jackcannon/hotline/docs/README.md

# Hotline documentation

| Page | Contents |
| --- | --- |
| [Build guide](build-guide.md) | Make a Hotline, step by step: parts, printing, the handset, the board, the wiring, flashing and testing |
| [Wiring](wiring.md) | The wiring diagram, the pin map, the ProtoMate layout, and each connection |
| [Firmware](firmware.md) | Build and flash the firmware, settings, how it works, known issues and troubleshooting |
| [3D-printed parts](../models/README.md) | The seven printed parts, where each one goes, and the print settings |
| [Wiring diagram (interactive)](hotline_complete_wiring_v12.html) | The same diagram as on the wiring page, as a web page with a dark mode |

To use a finished Hotline, see the [README](../README.md).
