jackcannon/hotline/assets/hotline-dial-card-2400.png

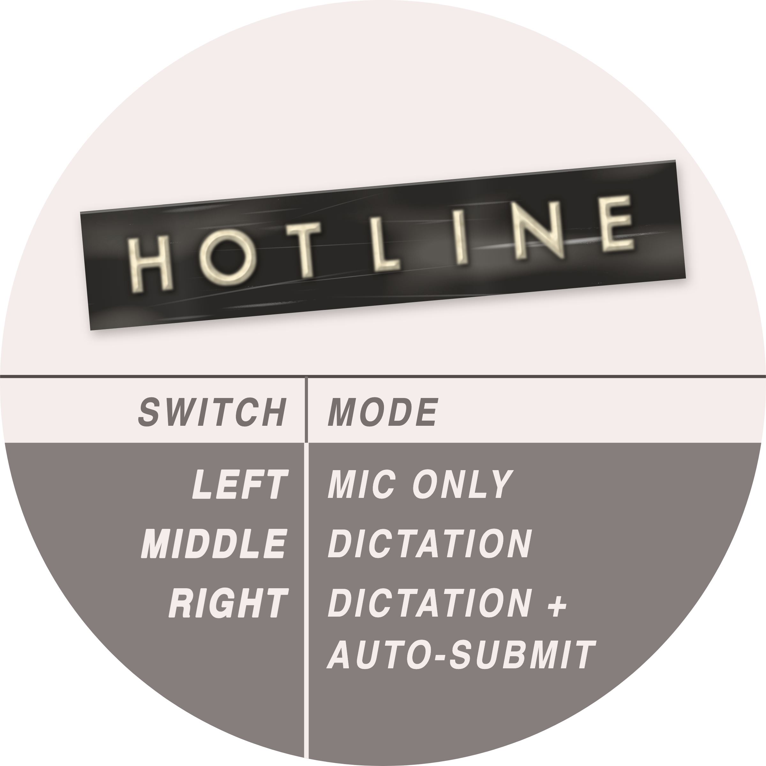
assets/hotline-dial-card-2400.png
