jackcannon/hotline/photos/hotline-desk.jpg

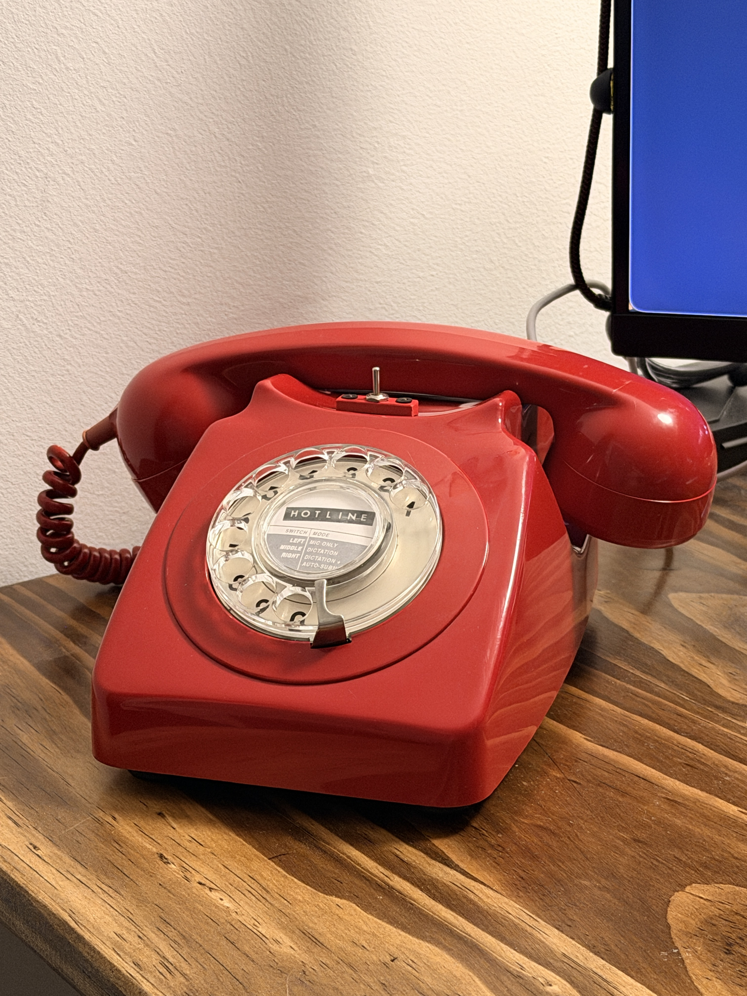
photos/hotline-desk.jpg
