jackcannon/hotline/models/Top Panel Main.stl

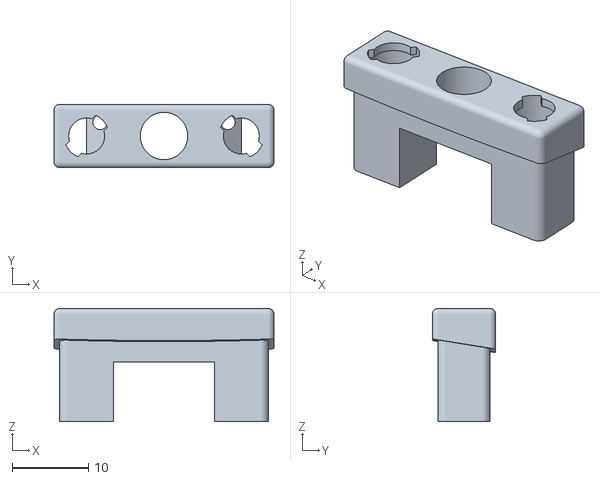
[picture p5: CAD file, 2026-10-31]
models/Top Panel Main.stl
28.8 x 8.30 x 14.8
