jackcannon/hotline/models/Back Port Cover.stl

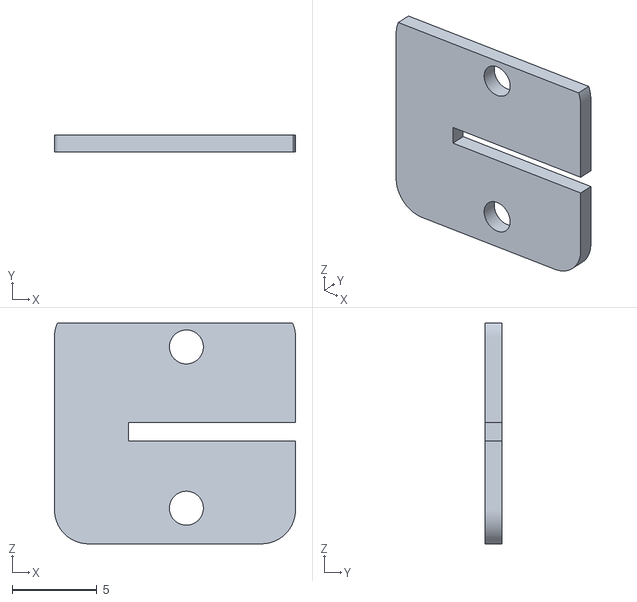
[picture p6: CAD file, 2026-10-31]
models/Back Port Cover.stl
14.2 x 1.00 x 13.0
