jackcannon/hotline/models/Microphone Cover.stl

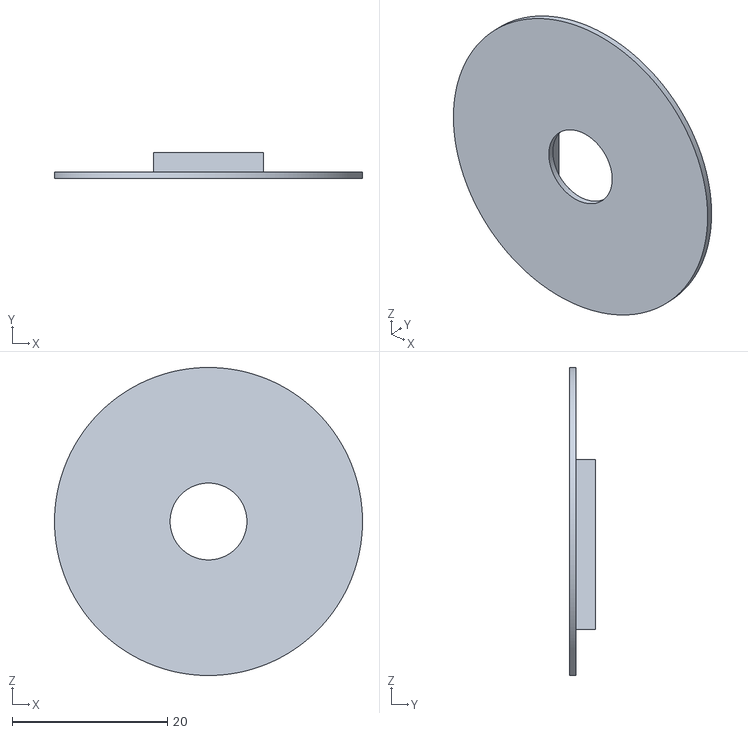
[picture p7: CAD file, 2026-10-31]
models/Microphone Cover.stl
39.7 x 3.30 x 39.7
