jackcannon/hotline/models/PRINT SETTINGS - 0.2mm.3mf

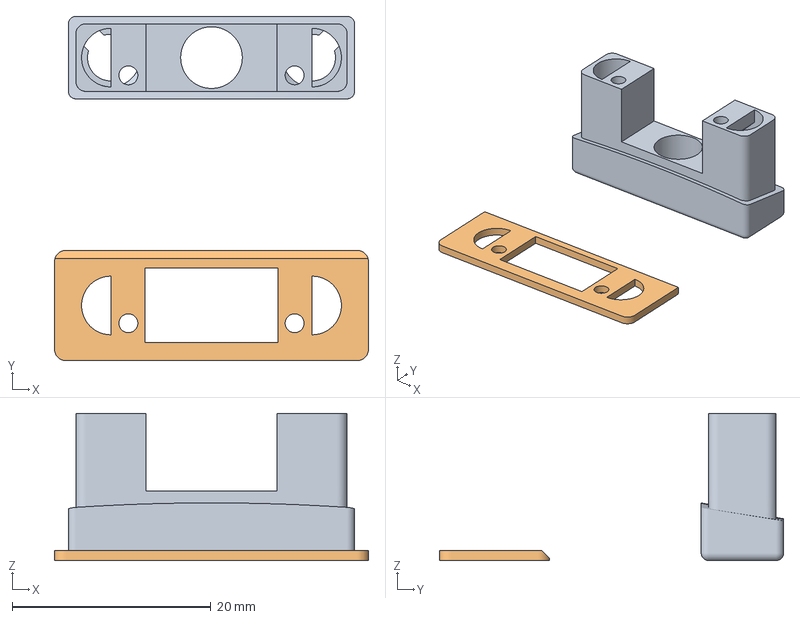
[picture p8: CAD file, 2026-10-31]
models/PRINT SETTINGS - 0.2mm.3mf
31.6 x 34.6 x 14.8 mm
Top Panel Main 4.stl
Top Panel Cap 4.stl
