jackcannon/hotline/models/Back Port Body.stl

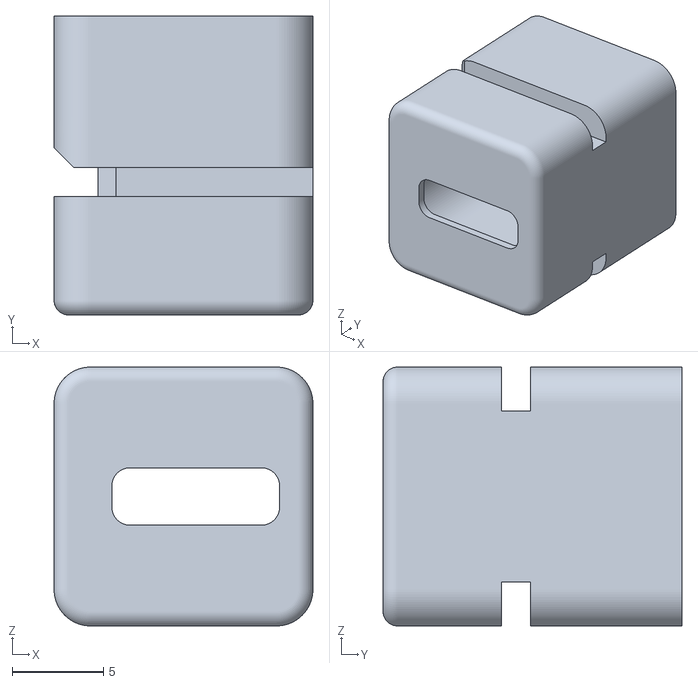
[picture p9: CAD file, 2026-10-31]
models/Back Port Body.stl
14.2 x 16.4 x 14.2
