jackcannon/hotline/models/Board Mount.stl

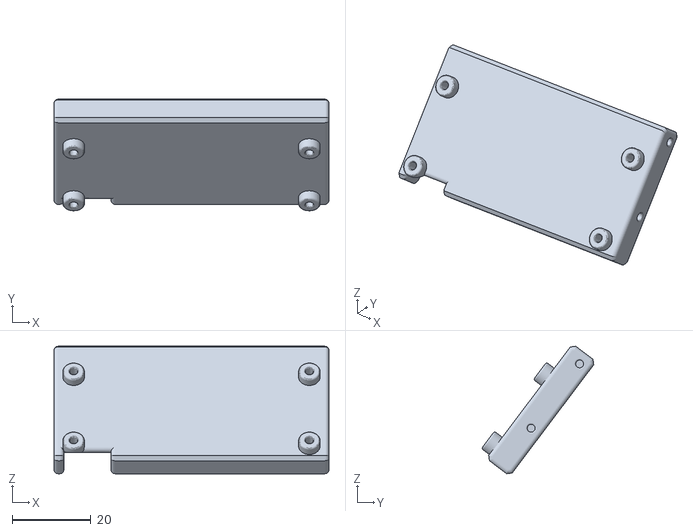
[picture p10: CAD file, 2026-10-31]
models/Board Mount.stl
70.0 x 28.4 x 32.5
