jackcannon/hotline/models/PRINT SETTINGS - 0.4mm.3mf

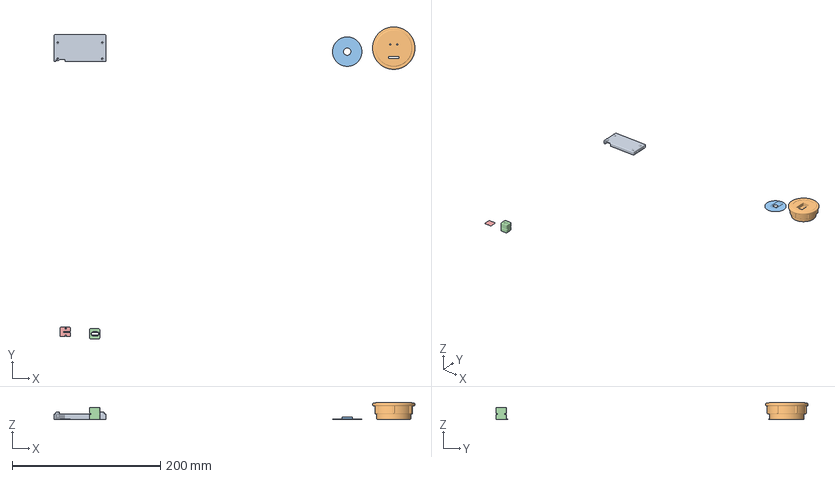
[picture p11: CAD file, 2026-10-31]
models/PRINT SETTINGS - 0.4mm.3mf
486.6 x 420.8 x 23.0 mm
Board Mount 1b.stl
Microphone Mount 2.stl
Microphone Cover 2.stl
Back Port Body 2b.stl
Back Port Cover 2.stl
