jackcannon/hotline/models/Top Panel Cap.stl

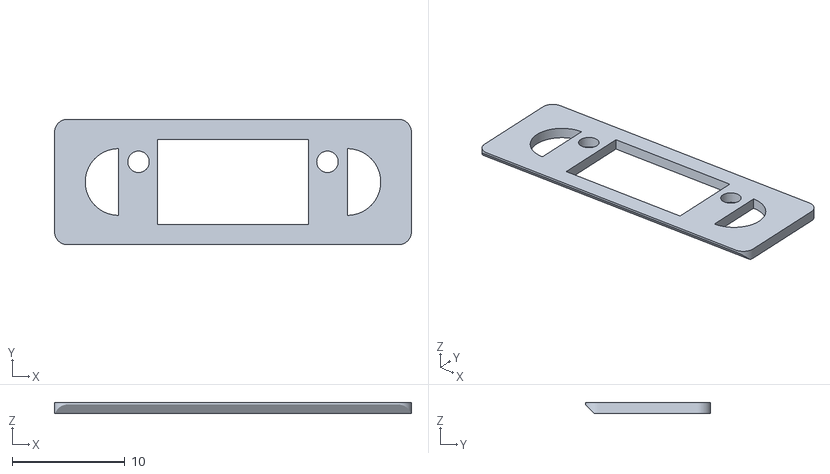
[picture p12: CAD file, 2026-10-31]
models/Top Panel Cap.stl
31.6 x 11.1 x 1.00
