jackcannon/hotline/models/Microphone Mount.stl

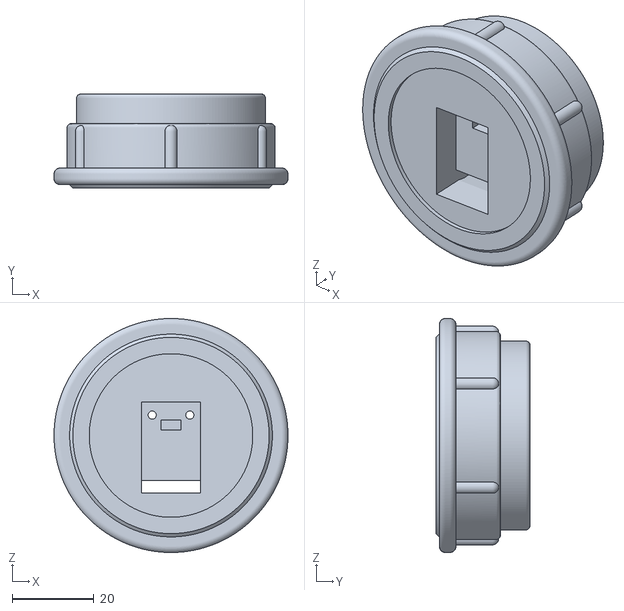
[picture p13: CAD file, 2026-10-31]
models/Microphone Mount.stl
57.2 x 23.0 x 57.2
