jackcannon/hotline/docs/hotline_complete_wiring_v12.html

## Complete wiring with grouped pins: cord on 3v, 0, 1G; resistor between 1I and 10I with a straight red bridge from 10G to pad 1; hook on 3; controls on 10, RX, SDA, SCL

Cord group: blue → 3v · white → 0 · red → 1G · green → ground rail

Speaker resistor: 1x4 female headers on 1F–1I and 10F–10I (outlined). Red bridge wire 10G → pad 1 (1A). 470Ω resistor between 1I and 10I. Resistors have no polarity, so it fits either way round. Path: pad 1 → bridge → column 10 → resistor → column 1 → red wire → speaker. Pins 1F and 10F (dashed) sit on the lower middle rails, so keep both lower rails empty, or leave those two header pins unsoldered

Hook group: 19 → pad 3 (yellow) · 19A → ground rail (brown)

Controls group: toggle pin A → RX (orange) · centre pin C → ground rail (brown) · pin B → 10 (purple). A and B are the two outer pins and are interchangeable (the firmware mapping flips with one setting); the centre pin must go to ground · green LED → SDA · red LED → SCL · LED black leads → ground rail

Pad 8: yours, left untouched. Gaps: 2 and TX. Spare: 9.

Ground rail, left to right: G link · green cord · hook 19A · spare · red LED black · green LED black · toggle centre
