jackcannon/hotline/(commit log)

2026-10-31 Add Hotline: firmware, docs, 3D models and assets
    Hotline turns a GPO 746 rotary phone into a USB-C dictation phone
    for the Mac. It appears as a USB microphone and a USB keyboard.
    - firmware: Pico SDK and TinyUSB firmware for the QT Py RP2040
    (UAC2 microphone, HID keyboard, three modes, sidetone, LEDs)
    - docs: build guide, wiring reference and firmware guide
    - models: STL files and print settings for the 7 printed parts
    - assets: logo and printable dial card
    - photos: the finished phone and its wiring
    [Back Port Body.stl, Back Port Cover.stl, Board Mount.stl, Microphone Cover.stl, Microphone Mount.stl, PRINT SETTINGS - 0.2mm.3mf, PRINT SETTINGS - 0.4mm.3mf, Top Panel Cap.stl]
2026-11-03 Replace the README photo with a new cut-out
    - photos/hotline.png: a new photo of the finished phone with the
    dial card. The background is removed, also between the cord coils
    and in the cradle gap. The edges are clean on light and dark pages.
    - photos/hotline-desk.jpg: the same photo, not cut, with the GPS
    location and the other metadata removed.
